Baizhou-713/TsetlinKWS/src_hw/sim/0yes_inf_result.txt

(array([0]), array([[ 2204,  -379, -1414, -1233,  -473,  -601, -1677, -1425, -1493,
         -350, -2066,    54]], dtype=int32))
