Baizhou-713/TsetlinKWS/src_sw/Init_ADAU1761.h

/*
 * File:           E:\SigmaStudio\Project\ADAU1761\Init_ADAU1761.h
 *
 * Created:        Thursday, May 22, 2025 4:07:13 PM
 * Description:    Design 1:ADAU1761 program data.
 *
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
 * This software may only be used to program products purchased from
 * Analog Devices for incorporation by you into audio products that
 * are intended for resale to audio product end users. This software
 * may not be distributed whole or in any part to third parties.
 *
 * Copyright ©2025 Analog Devices, Inc. All rights reserved.
 */
#ifndef __INIT_ADAU1761_H__
#define __INIT_ADAU1761_H__


#include "Init_ADAU1761_REG.h"

#define DEVICE_ARCHITECTURE_ADAU1761              "ADAU176x"
#define DEVICE_ADDR_ADAU1761                      0x0

typedef u8 ADI_REG_TYPE;

/* DSP Program Data */
#define PROGRAM_SIZE_ADAU1761 325
#define PROGRAM_ADDR_ADAU1761 2048
ADI_REG_TYPE Program_Data_ADAU1761[PROGRAM_SIZE_ADAU1761] = {
0x00, 0x00, 0x00, 0x00, 0x00, 
0xFE, 0xE0, 0x00, 0x00, 0x00, 
0xFF, 0x34, 0x00, 0x00, 0x00, 
0xFF, 0x2C, 0x00, 0x00, 0x00, 
0xFF, 0x54, 0x00, 0x00, 0x00, 
0xFF, 0x5C, 0x00, 0x00, 0x00, 
0xFF, 0xF5, 0x08, 0x20, 0x00, 
0xFF, 0x38, 0x00, 0x00, 0x00, 
0xFF, 0x80, 0x00, 0x00, 0x00, 
0x00, 0x00, 0x00, 0x00, 0x00, 
0x00, 0x00, 0x00, 0x00, 0x00, 
0xFE, 0xE8, 0x0C, 0x00, 0x00, 
0xFE, 0x30, 0x00, 0xE2, 0x00, 
0x00, 0x00, 0x00, 0x00, 0x00, 
0x00, 0x00, 0x00, 0x00, 0x00, 
0x00, 0x00, 0x00, 0x00, 0x00, 
0x00, 0x00, 0x00, 0x00, 0x00, 
0x00, 0x00, 0x00, 0x00, 0x00, 
0x00, 0x00, 0x00, 0x00, 0x00, 
0xFF, 0xE8, 0x07, 0x20, 0x08, 
0x00, 0x00, 0x06, 0xA0, 0x00, 
0xFF, 0xE0, 0x00, 0xC0, 0x00, 
0xFF, 0x80, 0x07, 0x00, 0x00, 
0x00, 0x00, 0x00, 0x00, 0x00, 
0xFF, 0x00, 0x00, 0x00, 0x00, 
0xFE, 0xC0, 0x22, 0x00, 0x27, 
0x00, 0x00, 0x00, 0x00, 0x00, 
0xFE, 0xE8, 0x1E, 0x00, 0x00, 
0xFF, 0xE8, 0x01, 0x20, 0x00, 
0xFF, 0xD8, 0x01, 0x03, 0x00, 
0x00, 0x07, 0xC6, 0x00, 0x00, 
0xFF, 0x08, 0x00, 0x00, 0x00, 
0xFF, 0xF4, 0x00, 0x20, 0x00, 
0xFF, 0xD8, 0x07, 0x02, 0x00, 
0xFD, 0xA5, 0x08, 0x20, 0x00, 
0x00, 0x10, 0x00, 0xE2, 0x00, 
0xFD, 0xAD, 0x08, 0x20, 0x00, 
0x00, 0x28, 0x00, 0xE2, 0x00, 
0x00, 0x50, 0x0B, 0x20, 0x00, 
0x00, 0x48, 0x0C, 0x22, 0x00, 
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
};

/* DSP Parameter (Coefficient) Data */
#define PARAM_SIZE_ADAU1761 52
#define PARAM_ADDR_ADAU1761 0
ADI_REG_TYPE Param_Data_ADAU1761[PARAM_SIZE_ADAU1761] = {
0x00, 0x00, 0x10, 0x00, 
0x00, 0x00, 0x00, 0x00, 
0x00, 0x00, 0x00, 0x00, 
0x00, 0x00, 0x00, 0x00, 
0x00, 0x00, 0x00, 0x00, 
0x00, 0x00, 0x00, 0x00, 
0x00, 0x00, 0x00, 0x00, 
0x00, 0x00, 0x00, 0x00, 
0x00, 0x48, 0xD6, 0x29, 
0x00, 0x91, 0xAC, 0x51, 
0x00, 0x48, 0xD6, 0x29, 
0x0F, 0x87, 0x52, 0x09, 
0x0F, 0xD5, 0x55, 0x55, 
};


/* Register Default - ADAU1761.Clock Control Register */
ADI_REG_TYPE R0_CLKCTRLREGISTER_ADAU1761_Default[REG_CLKCTRLREGISTER_ADAU1761_BYTE] = {
0x03
};

/* Register Default - ADAU1761.PLL Control Register */
ADI_REG_TYPE R1_PLLCRLREGISTER_ADAU1761_Default[REG_PLLCRLREGISTER_ADAU1761_BYTE] = {
0x02, 0x71, 0x00, 0xAD, 0x1B, 0x00
};

/* Register Default - ADAU1761.Delay */
#define R2_DELAY_ADAU1761_ADDR 0x0
#define R2_DELAY_ADAU1761_SIZE 2
ADI_REG_TYPE R2_DELAY_ADAU1761_Default[R2_DELAY_ADAU1761_SIZE] = {
0x00, 0x64
};

/* Register Default - ADAU1761.Serial Port Control Registers */
#define R3_SERIAL_PORT_CONTROL_REGISTERS_ADAU1761_SIZE 2
ADI_REG_TYPE R3_SERIAL_PORT_CONTROL_REGISTERS_ADAU1761_Default[R3_SERIAL_PORT_CONTROL_REGISTERS_ADAU1761_SIZE] = {
0x00, 0x00
};

/* Register Default - ADAU1761.ALC Control Registers */
#define R4_ALC_CONTROL_REGISTERS_ADAU1761_SIZE 4
ADI_REG_TYPE R4_ALC_CONTROL_REGISTERS_ADAU1761_Default[R4_ALC_CONTROL_REGISTERS_ADAU1761_SIZE] = {
0xE8, 0x3B, 0x25, 0x11
};

/* Register Default - ADAU1761.Microphone Control Register */
ADI_REG_TYPE R5_MICCTRLREGISTER_ADAU1761_Default[REG_MICCTRLREGISTER_ADAU1761_BYTE] = {
0x00
};

/* Register Default - ADAU1761.Record Input Signal Path Registers */
#define R6_RECORD_INPUT_SIGNAL_PATH_REGISTERS_ADAU1761_SIZE 8
ADI_REG_TYPE R6_RECORD_INPUT_SIGNAL_PATH_REGISTERS_ADAU1761_Default[R6_RECORD_INPUT_SIGNAL_PATH_REGISTERS_ADAU1761_SIZE] = {
0x00, 0x01, 0x10, 0x01, 0x10, 0xBB, 0xBB, 0x01
};

/* Register Default - ADAU1761.ADC Control Registers */
#define R7_ADC_CONTROL_REGISTERS_ADAU1761_SIZE 3
ADI_REG_TYPE R7_ADC_CONTROL_REGISTERS_ADAU1761_Default[R7_ADC_CONTROL_REGISTERS_ADAU1761_SIZE] = {
0x33, 0x00, 0x00
};

/* Register Default - ADAU1761.Playback Output Signal Path Registers */
#define R8_PLAYBACK_OUTPUT_SIGNAL_PATH_REGISTERS_ADAU1761_SIZE 14
ADI_REG_TYPE R8_PLAYBACK_OUTPUT_SIGNAL_PATH_REGISTERS_ADAU1761_Default[R8_PLAYBACK_OUTPUT_SIGNAL_PATH_REGISTERS_ADAU1761_SIZE] = {
0x00, 0x00, 0x00, 0x00, 0x00, 0x00, 0x00, 0xE4, 0xE5, 0xE4, 0xE4, 0xE4, 0x08, 0x00
};

/* Register Default - ADAU1761.Converter Control Registers */
#define R9_CONVERTER_CONTROL_REGISTERS_ADAU1761_SIZE 2
ADI_REG_TYPE R9_CONVERTER_CONTROL_REGISTERS_ADAU1761_Default[R9_CONVERTER_CONTROL_REGISTERS_ADAU1761_SIZE] = {
0x00, 0x00
};

/* Register Default - ADAU1761.DAC Control Registers */
#define R10_DAC_CONTROL_REGISTERS_ADAU1761_SIZE 3
ADI_REG_TYPE R10_DAC_CONTROL_REGISTERS_ADAU1761_Default[R10_DAC_CONTROL_REGISTERS_ADAU1761_SIZE] = {
0x03, 0x00, 0x00
};

/* Register Default - ADAU1761.Serial Port Pad Control Registers */
#define R11_SERIAL_PORT_PAD_CONTROL_REGISTERS_ADAU1761_SIZE 1
ADI_REG_TYPE R11_SERIAL_PORT_PAD_CONTROL_REGISTERS_ADAU1761_Default[R11_SERIAL_PORT_PAD_CONTROL_REGISTERS_ADAU1761_SIZE] = {
0xAA
};

/* Register Default - ADAU1761.Communication Port Pad Control Registers */
#define R12_COMMUNICATION_PORT_PAD_CONTROL_REGISTERS_ADAU1761_SIZE 2
ADI_REG_TYPE R12_COMMUNICATION_PORT_PAD_CONTROL_REGISTERS_ADAU1761_Default[R12_COMMUNICATION_PORT_PAD_CONTROL_REGISTERS_ADAU1761_SIZE] = {
0xAA, 0x00
};

/* Register Default - ADAU1761.Jack Detect Pad Control Register */
ADI_REG_TYPE R13_JACKREGISTER_ADAU1761_Default[REG_JACKREGISTER_ADAU1761_BYTE] = {
0x08
};

/* Register Default - ADAU1761.DSP ON Register */
ADI_REG_TYPE R14_DSP_ENABLE_REGISTER_ADAU1761_Default[REG_DSP_ENABLE_REGISTER_ADAU1761_BYTE] = {
0x01
};

/* Register Default - ADAU1761.CRC Registers */
#define R15_CRC_REGISTERS_ADAU1761_SIZE 5
ADI_REG_TYPE R15_CRC_REGISTERS_ADAU1761_Default[R15_CRC_REGISTERS_ADAU1761_SIZE] = {
0x7F, 0x09, 0x05, 0x7F, 0x00
};

/* Register Default - ADAU1761.GPIO Registers */
#define R16_GPIO_REGISTERS_ADAU1761_SIZE 4
ADI_REG_TYPE R16_GPIO_REGISTERS_ADAU1761_Default[R16_GPIO_REGISTERS_ADAU1761_SIZE] = {
0x00, 0x00, 0x00, 0x00
};

/* Register Default - ADAU1761.Non Modulo Registers */
#define R17_NON_MODULO_REGISTERS_ADAU1761_SIZE 2
ADI_REG_TYPE R17_NON_MODULO_REGISTERS_ADAU1761_Default[R17_NON_MODULO_REGISTERS_ADAU1761_SIZE] = {
0x10, 0x00
};

/* Register Default - ADAU1761.Watchdog Registers */
#define R18_WATCHDOG_REGISTERS_ADAU1761_SIZE 5
ADI_REG_TYPE R18_WATCHDOG_REGISTERS_ADAU1761_Default[R18_WATCHDOG_REGISTERS_ADAU1761_SIZE] = {
0x00, 0x00, 0x00, 0x00, 0x00
};

/* Register Default - ADAU1761.Sampling Rate Setting Register */
ADI_REG_TYPE R19_SAMPLE_RATE_SETTING_ADAU1761_Default[REG_SAMPLE_RATE_SETTING_ADAU1761_BYTE] = {
0x7F
};

/* Register Default - ADAU1761.Routing Matrix Inputs Register */
ADI_REG_TYPE R20_ROUTING_MATRIX_INPUTS_ADAU1761_Default[REG_ROUTING_MATRIX_INPUTS_ADAU1761_BYTE] = {
0x00
};

/* Register Default - ADAU1761.Routing Matrix Outputs Register */
ADI_REG_TYPE R21_ROUTING_MATRIX_OUTPUTS_ADAU1761_Default[REG_ROUTING_MATRIX_OUTPUTS_ADAU1761_BYTE] = {
0x00
};

/* Register Default - ADAU1761.Serial Data Configuration Register */
ADI_REG_TYPE R22_SERIAL_DATAGPIO_PIN_CONFIG_ADAU1761_Default[REG_SERIAL_DATAGPIO_PIN_CONFIG_ADAU1761_BYTE] = {
0x00
};

/* Register Default - ADAU1761.DSP Slew Mode Register */
ADI_REG_TYPE R23_DSP_SLEW_MODES_ADAU1761_Default[REG_DSP_SLEW_MODES_ADAU1761_BYTE] = {
0x00
};

/* Register Default - ADAU1761.Serial Port Sample Rate Register */
ADI_REG_TYPE R24_SERIAL_PORT_SAMPLE_RATE_SETTING_ADAU1761_Default[REG_SERIAL_PORT_SAMPLE_RATE_SETTING_ADAU1761_BYTE] = {
0x00
};

/* Register Default - ADAU1761.Clock Enable Registers */
#define R25_CLOCK_ENABLE_REGISTERS_ADAU1761_SIZE 2
ADI_REG_TYPE R25_CLOCK_ENABLE_REGISTERS_ADAU1761_Default[R25_CLOCK_ENABLE_REGISTERS_ADAU1761_SIZE] = {
0x7F, 0x03
};

/* Register Default - ADAU1761.Sample Rate Setting */
ADI_REG_TYPE R28_SAMPLE_RATE_SETTING_ADAU1761_Default[REG_SAMPLE_RATE_SETTING_ADAU1761_BYTE] = {
0x71
};

/* Register Default - ADAU1761.DSP Run Register */
ADI_REG_TYPE R29_DSP_RUN_REGISTER_ADAU1761_Default[REG_DSP_RUN_REGISTER_ADAU1761_BYTE] = {
0x01
};

/* Register Default - ADAU1761.Dejitter Register Control */
ADI_REG_TYPE R30_DEJITTER_REGISTER_CONTROL_ADAU1761_Default[REG_DEJITTER_REGISTER_CONTROL_ADAU1761_BYTE] = {
0x00
};

/* Register Default - ADAU1761.Dejitter Register Control */
ADI_REG_TYPE R31_DEJITTER_REGISTER_CONTROL_ADAU1761_Default[REG_DEJITTER_REGISTER_CONTROL_ADAU1761_BYTE] = {
0x03
};


/*
 * Default Download

#define DEFAULT_DOWNLOAD_SIZE_ADAU1761 32

void default_download_ADAU1761() {
	SIGMA_WRITE_REGISTER_BLOCK( DEVICE_ADDR_ADAU1761, REG_CLKCTRLREGISTER_ADAU1761_ADDR, REG_CLKCTRLREGISTER_ADAU1761_BYTE, R0_CLKCTRLREGISTER_ADAU1761_Default );
	SIGMA_WRITE_REGISTER_BLOCK( DEVICE_ADDR_ADAU1761, REG_PLLCRLREGISTER_ADAU1761_ADDR, REG_PLLCRLREGISTER_ADAU1761_BYTE, R1_PLLCRLREGISTER_ADAU1761_Default );
	SIGMA_WRITE_DELAY( DEVICE_ADDR_ADAU1761, R2_DELAY_ADAU1761_SIZE, R2_DELAY_ADAU1761_Default );
	SIGMA_WRITE_REGISTER_BLOCK( DEVICE_ADDR_ADAU1761, REG_SERIAL_PORT_CONTROL_0_ADAU1761_ADDR , R3_SERIAL_PORT_CONTROL_REGISTERS_ADAU1761_SIZE, R3_SERIAL_PORT_CONTROL_REGISTERS_ADAU1761_Default );
	SIGMA_WRITE_REGISTER_BLOCK( DEVICE_ADDR_ADAU1761, REG_ALC_CONTROL_0_ADAU1761_ADDR , R4_ALC_CONTROL_REGISTERS_ADAU1761_SIZE, R4_ALC_CONTROL_REGISTERS_ADAU1761_Default );
	SIGMA_WRITE_REGISTER_BLOCK( DEVICE_ADDR_ADAU1761, REG_MICCTRLREGISTER_ADAU1761_ADDR, REG_MICCTRLREGISTER_ADAU1761_BYTE, R5_MICCTRLREGISTER_ADAU1761_Default );
	SIGMA_WRITE_REGISTER_BLOCK( DEVICE_ADDR_ADAU1761, REG_RECORD_PWR_MANAGEMENT_ADAU1761_ADDR , R6_RECORD_INPUT_SIGNAL_PATH_REGISTERS_ADAU1761_SIZE, R6_RECORD_INPUT_SIGNAL_PATH_REGISTERS_ADAU1761_Default );
	SIGMA_WRITE_REGISTER_BLOCK( DEVICE_ADDR_ADAU1761, REG_ADC_CONTROL_0_ADAU1761_ADDR , R7_ADC_CONTROL_REGISTERS_ADAU1761_SIZE, R7_ADC_CONTROL_REGISTERS_ADAU1761_Default );
	SIGMA_WRITE_REGISTER_BLOCK( DEVICE_ADDR_ADAU1761, REG_PLAYBACK_MIXER_LEFT_CONTROL_0_ADAU1761_ADDR , R8_PLAYBACK_OUTPUT_SIGNAL_PATH_REGISTERS_ADAU1761_SIZE, R8_PLAYBACK_OUTPUT_SIGNAL_PATH_REGISTERS_ADAU1761_Default );
	SIGMA_WRITE_REGISTER_BLOCK( DEVICE_ADDR_ADAU1761, REG_CONVERTER_CTRL_0_ADAU1761_ADDR , R9_CONVERTER_CONTROL_REGISTERS_ADAU1761_SIZE, R9_CONVERTER_CONTROL_REGISTERS_ADAU1761_Default );
	SIGMA_WRITE_REGISTER_BLOCK( DEVICE_ADDR_ADAU1761, REG_DAC_CONTROL_0_ADAU1761_ADDR , R10_DAC_CONTROL_REGISTERS_ADAU1761_SIZE, R10_DAC_CONTROL_REGISTERS_ADAU1761_Default );
	SIGMA_WRITE_REGISTER_BLOCK( DEVICE_ADDR_ADAU1761, REG_SERIAL_PORT_PAD_CONTROL_0_ADAU1761_ADDR , R11_SERIAL_PORT_PAD_CONTROL_REGISTERS_ADAU1761_SIZE, R11_SERIAL_PORT_PAD_CONTROL_REGISTERS_ADAU1761_Default );
	SIGMA_WRITE_REGISTER_BLOCK( DEVICE_ADDR_ADAU1761, REG_COMM_PORT_PAD_CTRL_0_ADAU1761_ADDR , R12_COMMUNICATION_PORT_PAD_CONTROL_REGISTERS_ADAU1761_SIZE, R12_COMMUNICATION_PORT_PAD_CONTROL_REGISTERS_ADAU1761_Default );
	SIGMA_WRITE_REGISTER_BLOCK( DEVICE_ADDR_ADAU1761, REG_JACKREGISTER_ADAU1761_ADDR, REG_JACKREGISTER_ADAU1761_BYTE, R13_JACKREGISTER_ADAU1761_Default );
	SIGMA_WRITE_REGISTER_BLOCK( DEVICE_ADDR_ADAU1761, REG_DSP_ENABLE_REGISTER_ADAU1761_ADDR, REG_DSP_ENABLE_REGISTER_ADAU1761_BYTE, R14_DSP_ENABLE_REGISTER_ADAU1761_Default );
	SIGMA_WRITE_REGISTER_BLOCK( DEVICE_ADDR_ADAU1761, REG_CRC_IDEAL_1_ADAU1761_ADDR , R15_CRC_REGISTERS_ADAU1761_SIZE, R15_CRC_REGISTERS_ADAU1761_Default );
	SIGMA_WRITE_REGISTER_BLOCK( DEVICE_ADDR_ADAU1761, REG_GPIO_0_CONTROL_ADAU1761_ADDR , R16_GPIO_REGISTERS_ADAU1761_SIZE, R16_GPIO_REGISTERS_ADAU1761_Default );
	SIGMA_WRITE_REGISTER_BLOCK( DEVICE_ADDR_ADAU1761, REG_NON_MODULO_RAM_1_ADAU1761_ADDR , R17_NON_MODULO_REGISTERS_ADAU1761_SIZE, R17_NON_MODULO_REGISTERS_ADAU1761_Default );
	SIGMA_WRITE_REGISTER_BLOCK( DEVICE_ADDR_ADAU1761, REG_WATCHDOG_ENABLE_ADAU1761_ADDR , R18_WATCHDOG_REGISTERS_ADAU1761_SIZE, R18_WATCHDOG_REGISTERS_ADAU1761_Default );
	SIGMA_WRITE_REGISTER_BLOCK( DEVICE_ADDR_ADAU1761, REG_SAMPLE_RATE_SETTING_ADAU1761_ADDR, REG_SAMPLE_RATE_SETTING_ADAU1761_BYTE, R19_SAMPLE_RATE_SETTING_ADAU1761_Default );
	SIGMA_WRITE_REGISTER_BLOCK( DEVICE_ADDR_ADAU1761, REG_ROUTING_MATRIX_INPUTS_ADAU1761_ADDR, REG_ROUTING_MATRIX_INPUTS_ADAU1761_BYTE, R20_ROUTING_MATRIX_INPUTS_ADAU1761_Default );
	SIGMA_WRITE_REGISTER_BLOCK( DEVICE_ADDR_ADAU1761, REG_ROUTING_MATRIX_OUTPUTS_ADAU1761_ADDR, REG_ROUTING_MATRIX_OUTPUTS_ADAU1761_BYTE, R21_ROUTING_MATRIX_OUTPUTS_ADAU1761_Default );
	SIGMA_WRITE_REGISTER_BLOCK( DEVICE_ADDR_ADAU1761, REG_SERIAL_DATAGPIO_PIN_CONFIG_ADAU1761_ADDR, REG_SERIAL_DATAGPIO_PIN_CONFIG_ADAU1761_BYTE, R22_SERIAL_DATAGPIO_PIN_CONFIG_ADAU1761_Default );
	SIGMA_WRITE_REGISTER_BLOCK( DEVICE_ADDR_ADAU1761, REG_DSP_SLEW_MODES_ADAU1761_ADDR, REG_DSP_SLEW_MODES_ADAU1761_BYTE, R23_DSP_SLEW_MODES_ADAU1761_Default );
	SIGMA_WRITE_REGISTER_BLOCK( DEVICE_ADDR_ADAU1761, REG_SERIAL_PORT_SAMPLE_RATE_SETTING_ADAU1761_ADDR, REG_SERIAL_PORT_SAMPLE_RATE_SETTING_ADAU1761_BYTE, R24_SERIAL_PORT_SAMPLE_RATE_SETTING_ADAU1761_Default );
	SIGMA_WRITE_REGISTER_BLOCK( DEVICE_ADDR_ADAU1761, REG_CLOCK_ENABLE_REG_0_ADAU1761_ADDR , R25_CLOCK_ENABLE_REGISTERS_ADAU1761_SIZE, R25_CLOCK_ENABLE_REGISTERS_ADAU1761_Default );
	SIGMA_WRITE_REGISTER_BLOCK( DEVICE_ADDR_ADAU1761, PROGRAM_ADDR_ADAU1761, PROGRAM_SIZE_ADAU1761, Program_Data_ADAU1761 );
	SIGMA_WRITE_REGISTER_BLOCK( DEVICE_ADDR_ADAU1761, PARAM_ADDR_ADAU1761, PARAM_SIZE_ADAU1761, Param_Data_ADAU1761 );
	SIGMA_WRITE_REGISTER_BLOCK( DEVICE_ADDR_ADAU1761, REG_SAMPLE_RATE_SETTING_ADAU1761_ADDR, REG_SAMPLE_RATE_SETTING_ADAU1761_BYTE, R28_SAMPLE_RATE_SETTING_ADAU1761_Default );
	SIGMA_WRITE_REGISTER_BLOCK( DEVICE_ADDR_ADAU1761, REG_DSP_RUN_REGISTER_ADAU1761_ADDR, REG_DSP_RUN_REGISTER_ADAU1761_BYTE, R29_DSP_RUN_REGISTER_ADAU1761_Default );
	SIGMA_WRITE_REGISTER_BLOCK( DEVICE_ADDR_ADAU1761, REG_DEJITTER_REGISTER_CONTROL_ADAU1761_ADDR, REG_DEJITTER_REGISTER_CONTROL_ADAU1761_BYTE, R30_DEJITTER_REGISTER_CONTROL_ADAU1761_Default );
	SIGMA_WRITE_REGISTER_BLOCK( DEVICE_ADDR_ADAU1761, REG_DEJITTER_REGISTER_CONTROL_ADAU1761_ADDR, REG_DEJITTER_REGISTER_CONTROL_ADAU1761_BYTE, R31_DEJITTER_REGISTER_CONTROL_ADAU1761_Default );
}
 */
#endif
